ZaraeQurashi/KeySync/BOM.csv

Item | Qty | Supplier | Cost/item | Total Cost | link
XIAO ESP32-C3 | 1 | RobotShop | $9.86 | $9.86 | https://ca.robotshop.com/products/seeedstudio-seeed-studio-xiao-esp32-s3-tape-reel
EC11 Rotary Encoder | 1 | RobotShop | $4.14 | $4.14 | https://ca.robotshop.com/products/ec11-rotary-encoder-module
Kai-lh Low Profile Switches | 10 | Amazon | $1.41 | $14.10 | https://www.amazon.ca/Profile-Switches-Tactile-Mechanical-Keyboard/dp/B0F5MP57JP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
PCB Board | 1 | JLPCB | $5.59 | $5.59 | https://cart.jlcpcb.com/quote?spm=Jlcpcb.Partcart.1003
Estimated total shipping | 1 |  |  | $25.00
