ZaraeQurashi/KeySync/PCB/Keysync.kicad_pcb

## KiCad design PCB/Keysync.kicad_pcb (2026-10-26)

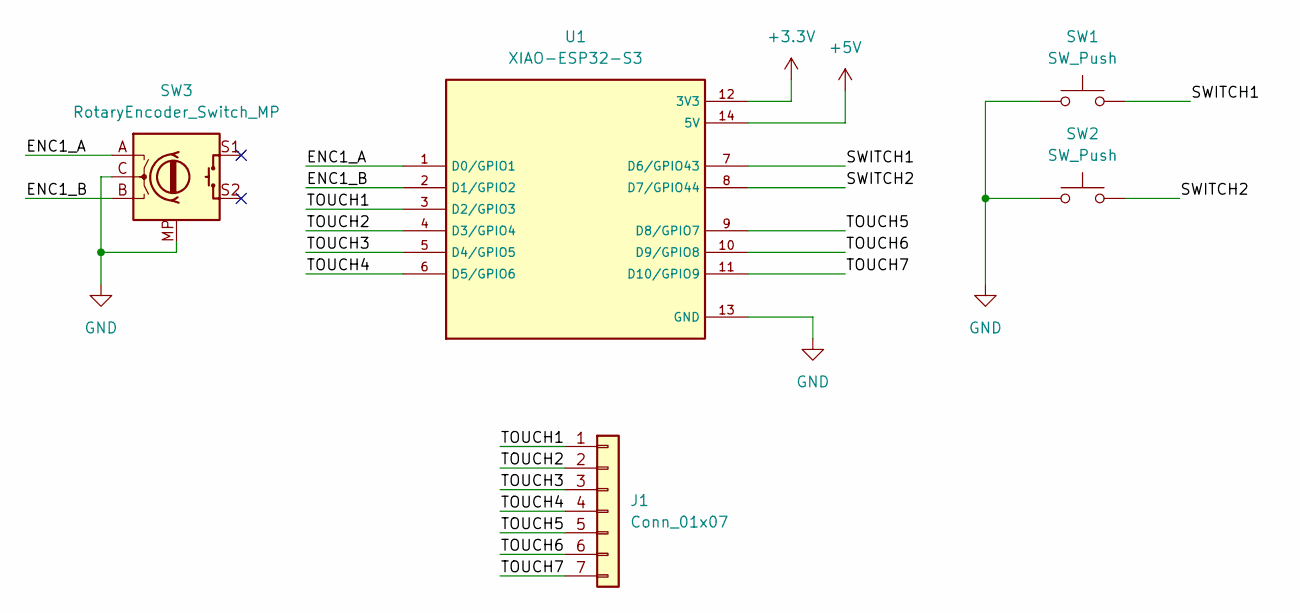
[picture p1: schematic Keysync.kicad_sch]

Parts:
J1: Conn_01x07; Capacitative Keys Heart
SW1, SW2: SW_Push; Kailh Choc Low-Profile Switches
SW3: RotaryEncoder_Switch_MP; RotaryEncoder_Alps_EC11E-Switch_Vertical_H20mm
U1: XIAO-ESP32-S3; XIAO ESP32-S3; PARTREV April 22nd, 2026

Connections:
+3.3V: U1.12 (3V3)
+5V: U1.14 (5V)
/ENC1_A: SW3.A, U1.1 (D0/GPIO1)
/ENC1_B: SW3.B, U1.2 (D1/GPIO2)
/SWITCH1: SW1.2, U1.7 (D6/GPIO43)
/SWITCH2: SW2.2, U1.8 (D7/GPIO44)
/TOUCH1: J1.1, U1.3 (D2/GPIO3)
/TOUCH2: J1.2, U1.4 (D3/GPIO4)
/TOUCH3: J1.3, U1.5 (D4/GPIO5)
/TOUCH4: J1.4, U1.6 (D5/GPIO6)
/TOUCH5: J1.5, U1.9 (D8/GPIO7)
/TOUCH6: J1.6, U1.10 (D9/GPIO8)
/TOUCH7: J1.7, U1.11 (D10/GPIO9)
GND: SW1.1, SW2.1, SW3.C, SW3.MP, U1.13 (GND)

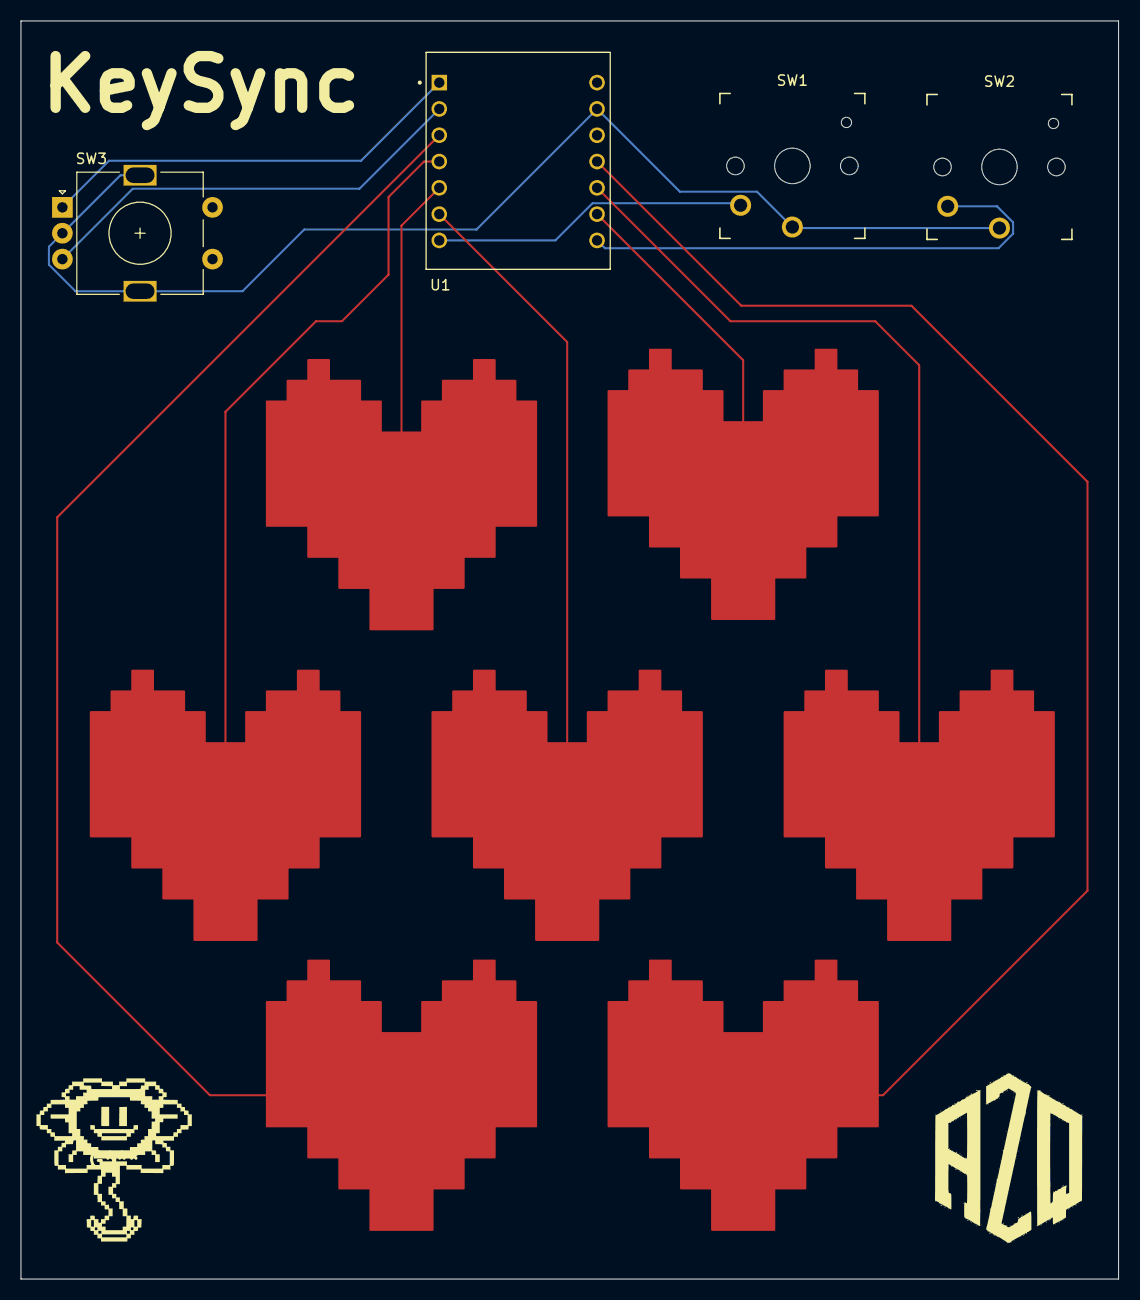
[picture p2: board Keysync.kicad_pcb from above]

Board: 2 copper layers, 106.0 x 121.5 mm, 5 parts (0 on the bottom side), 12 nets.
