ZaraeQurashi/KeySync/JOURNAL.md

# KeySync — Custom MIDI Controller – devlog

<!-- Generated by Half Life from project cmvfsln3600vu01rp9hzonozl. Edits here are overwritten on the next sync. -->
<!-- Generated: 2026-10-26T01:23:02.331Z -->

> [!NOTE]
> This devlog is mirrored from [Half Life](https://halflife.hackclub.com) – [open the project](https://halflife.hackclub.com/projects/cmvfsln3600vu01rp9hzonozl). Editing it here will not change the platform's copy, and the next sync overwrites this file.

> A custom MIDI keypad PCB that combines hardware design and music technology. Featuring mechanical switches, sliders, rotary encoders, NeoPixels, and capacitive touch to create a personalized MIDI controller for interactive music production. Designed with homage to UNDERTALE with capacitive keys based off the 7 souls and unique art.

| Week | Tier | Hours logged | Entries |
| --- | --- | --- | --- |
| Week 3 | Tier 1 | 15.02h | 4 |

## Contents

1. [2026-10-22 – # KeySync - Day 1](#2026-10-22-keysync---day-1)
2. [2026-10-25 – # KeySync — Day 2: Custom Footprints, PCB Layout, A lot of Revisions and Routing](#2026-10-25-keysync-day-2-custom-footprints-pcb-layout-a-lot-)
3. [2026-10-25 – Work session](#2026-10-25-work-session)
4. [2026-10-25 – # KeySync — Final Journal: Firmware, BOM, and GitHub README](#2026-10-25-keysync-final-journal-firmware-bom-and-github-rea)

## Design

### 2026-10-22 – # KeySync - Day 1

**3h**

# KeySync - Day 1
### Project planning and initial schematic

Today, I started planning my new hardware project, KeySync, a custom MIDI keyboard designed to combine music tech, electronics and pcb design. My goal is to make a compact personalized MIDI controller that can interact with music production software but also lets me build a more advanced circuit board.

For the main microcontroller, I decieded to use the XIAO ESP32-C3 because it's cheaper and I'm broke. This microcontroller will process the inputs and communicate with a computer. However, the xiao is limited in its ports so the controller will only feature capacitive touch switches, low profile switches and a rotary encoder.

My first focus was to identify the components I would need before beginning the schematic in KiCad. I  started by downloading the necessary footprints and symbol libraries before configuring them as well as the symbol pathways.



From there I began importing my parts into the schematic. I started with the capacitive keys that I'm going to use a 01x07 switch. I needed to research and check online for the correct pin layout that would allow the xiao to actually read the inputs so I connected the switches 7 pins to d0-d5 and d10.

Next were the two low profile switches which I connected to ground together and wired to Xiao's d6 and d7 pins. After I wired up the rotary encoder by connecting its A and B ports to D8 and D9 while connection the MB and C ports to ground. I cut off the S1 and S2 ports. On top of this I also added the ground, 3.3v and 5v connection for the XIAO, completing the schematic



Finally, I assigned the footprints to every component that I had downloaded from before and saved the footprints tags to my schematic. The switches (SW_PUSH) were just assigned to the "Kailh Choc Low-Profile Switches" footprint I downloaded, while the rotary encoder was assigned the vertical EC11 footprint. For now I left the 01x07 switch footprint empty to customize it's footprint as a capitative keys later.



Summary: Finished up my project design and connected all the different components in the schematic as well as assigning their footprints which had to be downloaded.

Next time: Begin designing the actual PCB and adding custom details.

### 2026-10-25 – # KeySync — Day 2: Custom Footprints, PCB Layout, A lot of Revisions and Routing

**6h**

# KeySync — Day 2: Custom Footprints, PCB Layout, A lot of Revisions and Routing
Oct 23th, 2026 + Oct 24th

Today, I focused on building the physical PCB design for KeySync from the completed schematic. My goal was to create the custom copper electrodes for the capacitive touch keys, establish the board outline, position the components, and complete the routing.

## 1. Designing Custom Heart-Shaped Touch Pads

One of my first tasks was building the custom footprint for the capacitive touch keys. When thinking about what custom shape I wanted to use for the pads, I decided I wanted them to have a heart shape from the game UNDERTALE. I thought it would be a perfect fit since one of my favourite game soundtracks is UNDERTALE and one of the most prominent images is the 7 souls so I could have each pad represent a soul.

I created the heart-shaped pads in KiCad, sketching out a polygon based on a reference image before merging it with a pad. Then I copied it and arranged all 7 hearts like how they show up in the game.



From there I built a rectangular courtyard around my pads on the F.courtyard layer. Before saving my footprint, adding it to a custom library and assigning it to the component in my schematic.



## 2. Building the Physical PCB and Board Outline

After designing the touch pads, I began turning the schematic into a physical PCB layout. I imported the XIAO ESP32, low-profile switches, rotary encoder, and my new footprint for the touch keys while thinking about how their connections would be routed.

I created the PCB board outline to establish the board's physical boundaries. Originally, I planned on having a heart shaped PCB outline like this image. But then I realized that it would look bad since my keys were already heart shaped so I decided to go with a simple rectangular outline. This gave me a clear reference for my components and helped me assess how much space was available for the complete design.



## 3. Fixing the capacitive key Footprint
One problem I ran into was that the capacitive key footprint was too big for the actual PCB layout, first I tried just shrinking the courtyard, then I tried bringing the pads closer before realizing that the hearts were too big so I redid my footprint. I reimported my reference image, scaled it down, recopied the hearts and merged them with pads to finish up my new properly sized footprint. This taught me that I can't just assume a footprint will fit because it looks fine in KiCad. I need to check its dimensions and make sure it matches the actual component I'm planning to use.

From there, I reimported all my components from the schematic onto my PCB and organized them but quickly realized I had another small issue.

## 4. Fixing the schematic

When I was organizing what components I wanted where on my board, I decided I wanted the two switches to be on one side of the microcontroller with the encoder on the left side and the keys below everything. But then as I started routing I realized that my encoder had a lot of connection on the right side of the esp32 so I went into my schematic to redo all my connections.

I moved two of the key connections to the right side to move the encoder connections to the left, this way the encoder and switches were able to easily be routed to the esp32. I imported my components into the PCB  again and arranged them again this time checking the routes to make sure I could easily route all my components.



As I worked on the PCB, I noticed that I needed to make some changes to the schematic and how certain components were connected. I also had to change the pad numbers on some of my custom footprints a few times to make routing easier.



Here you can see a picture of my edited schematic where I moved the components to where they would physically be on the board while also redoing some of the connections.

## 5. Routing the Pad numbers
I began routing everything but realized my pad numbers and their respective connections on the esp32 were all over the place. Originally I had numbered my pads left to right going down but I realized that this method meant I would block off some of the connections.

From there I did some quick trial and error where instead of changing the schematic, I changed the pad numbers, imported the new version of the footprint and checked how they routed.


Picture of one of my edits which wasn't even the final version.

But after a bit of time, I ended with a layout that I thought routed easily enough to use.



## 6. Routing the components
So now that all my components could be routed easily, I decided to do my keys on the F.cu layer and the other switches + encoder on the B.cu layer which ultimately gave me this.



## Summary

I created seven heart-shaped touch pads, finished the board outline, fixed an oversized footprint, and made changes to the schematic and pad numbers. I also finished routing the switches on the back copper layer and the touch keys on the front. Most of the main PCB layout is now done, so I can start focusing on the artwork and checking that everything is ready to be manufactured.

## Next steps
- Add extra UNDERTALE/DELTARUNE-inspired art and the KeySync name as well as my initials into the PCB silkscreen.
- Check the 3D view to make sure the components fit and there are no obvious spacing issues.
- Put together a bill of materials (BOM) listing the parts I'll need.
- Start properly building  the GitHub README with the project description, components, design process, and progress pictures.

### 2026-10-25 – Work session

**2.02h**

[Timelapse](https://lookout.hackclub.com/api/media/efd166ee-d361-422c-bd8c-5fd943478550/video.mp4)

### 2026-10-25 – # KeySync — Final Journal: Firmware, BOM, and GitHub README

**4h**

# KeySync — Final Journal: Firmware, BOM, and GitHub README
October 25, 2026

Today, I focused on bringing the final parts of KeySync together: the bill of materials (BOM), Python firmware, and GitHub README. I had already completed the PCB design, including the custom board outline, component placement, routing, and seven heart-shaped capacitive touch pads inspired by UNDERTALE.

Although the hardware design was finished, getting the project organized took more work than I expected. I needed to make sure the component list matched the design, the firmware used the correct GPIO assignments, and the README explained the project clearly. The firmware was especially challenging because I had to work through compatibility issues before settling on a CircuitPython and KMK approach.

## 1. Building the Bill of Materials

I started by creating the BOM to document the components needed to build KeySync. I went through the main parts, checked their quantities and prices, and added purchasing links so the components would be easier to source.

My list included the XIAO ESP32-S3, an EC11 rotary encoder, ten low-profile mechanical switches, and the custom PCB from JLCPCB. I also estimated shipping costs to get a better idea of the overall project budget. Although my design only uses two mechanical pushbuttons, I included a pack of ten switches because they are purchased together.

Based on my listed prices taken from RobotShop, Amazon and JLPPCB, the components and PCB cost **$33.69**, with an estimated **$25.00 for shipping**, bringing the total to **$58.69** before any applicable taxes or additional fees. This gave me a clearer idea of the cost of building the controller and made the project easier to reproduce.



## 2. Developing the CircuitPython Firmware

Next, I worked on the firmware using CircuitPython and KMK. The goal was to make the controls behave as intended and ensure the software matched the final GPIO assignments on my XIAO ESP32-S3.

I organized the code into separate sections for input scanning, key mappings, the rotary encoder, and the KMK modules and extensions. Keeping these parts separate made the code easier to follow and helped me understand how each component contributed to the controller's behaviour.

The seven capacitive touch keys were assigned MIDI note numbers **60, 62, 64, 65, 67, 69, and 71**, corresponding to a C-major scale. The two mechanical switches were assigned notes **36 and 38**, intended for kick drum and snare sounds in compatible General MIDI drum mappings.

For the touch keys, I created a custom `TouchScanner` class using CircuitPython's `touchio` module. It checks the state of each touch pad and compares it with its previous state. When a pad changes between touched and untouched, the scanner generates a keypad event for KMK to process. This was necessary because the heart-shaped touch pads do not behave like ordinary mechanical switches.

I configured the two physical switches using KMK's `KeysScanner`, with pull-up inputs because the switches connect their GPIO pins to ground when pressed. I also configured the rotary encoder on GPIO1 and GPIO2, mapping its rotation to volume-down and volume-up commands through KMK's media-key extension.

Finally, I connected the input scanners, MIDI module, encoder handler, and media-key extension to the main keyboard object before starting the controller with `keyboard.go()`.





## 3. Troubleshooting the Firmware

The firmware was the most challenging part of the final stage. I initially explored an Arduino-based approach, but encountered compatibility problems involving USB MIDI classes, MIDI event types, and capacitive touch functions. Code and libraries that seemed suitable in one environment did not necessarily work with the board and setup I was using.

I eventually switched to CircuitPython and KMK, which meant reworking the implementation rather than simply transferring my earlier code. I had to understand how KMK handles key scanning, how the keymap translates input events into actions, and how extensions and modules provide additional functionality.

Another challenge was keeping the GPIO assignments consistent. I used GPIO3–GPIO9 for the touch pads, GPIO43 and GPIO44 for the mechanical switches, and GPIO1 and GPIO2 for the encoder. I documented these assignments and organized them in the code so they could be compared against the PCB design.

I also had to distinguish between MIDI controls and ordinary computer controls. The touch pads and pushbuttons use MIDI note mappings, while the rotary encoder uses media-key commands to adjust the computer's system volume. This means the encoder does not directly send MIDI Control Change messages to adjust an instrument parameter.

Writing the custom touch scanner helped me better understand how input events work. Instead of repeatedly treating a held touch as a new press, the scanner tracks the previous state and only reports a change.



## 4. Writing the GitHub README



Once the BOM and firmware were organized, I wrote the GitHub README to document KeySync from start to finish. I wanted someone visiting the repository to understand the project's purpose, its design, the components required, and how the firmware was structured.

I added an introduction explaining the UNDERTALE inspiration, followed by sections covering the hardware, PCB design, controls and MIDI note mappings, firmware, and the challenges I encountered. I also included tables for the GPIO assignments and control mappings so the technical information would be easy to reference.

I added images of the PCB, schematic, touch pads, mechanical switches, rotary encoder, and firmware. These visuals helped demonstrate the work more clearly than text alone, particularly the custom heart-shaped electrodes that make the design recognizable.





## Final Summary

KeySync brought together PCB design, programming, and creative design into a custom MIDI controller inspired by UNDERTALE.

I completed the BOM, developed the CircuitPython/KMK firmware, and documented the project on GitHub, including its hardware, controls, and design process.
