ZaraeQurashi/KeySync/(commit log)

2026-10-23 Sync KeySync — Custom MIDI Controller from Half Life
    [BOM.csv]
2026-10-26 Revise README for KeySync MIDI Controller
    Updated the README to provide a detailed overview of the KeySync MIDI controller, including project inspiration, hardware components, PCB design, controls, and firmware structure.
2026-10-26 Rename Keysync-NPTH.drl to DRL Files/Keysync-NPTH.drl
    [Keysync-NPTH.drl]
2026-10-26 Rename Keysync-PTH.drl to DRL Files/Keysync-PTH.drl
    [Keysync-PTH.drl]
2026-10-26 Rename DRL Files/Keysync-NPTH.drl to PCB/DRL Files/Keysync-NPTH.drl
    [Keysync-NPTH.drl]
2026-10-26 Rename DRL Files/Keysync-PTH.drl to PCB/DRL Files/Keysync-PTH.drl
    [Keysync-PTH.drl]
